Team-Sensorium/SensoBot/Images/Screenshot (390).png

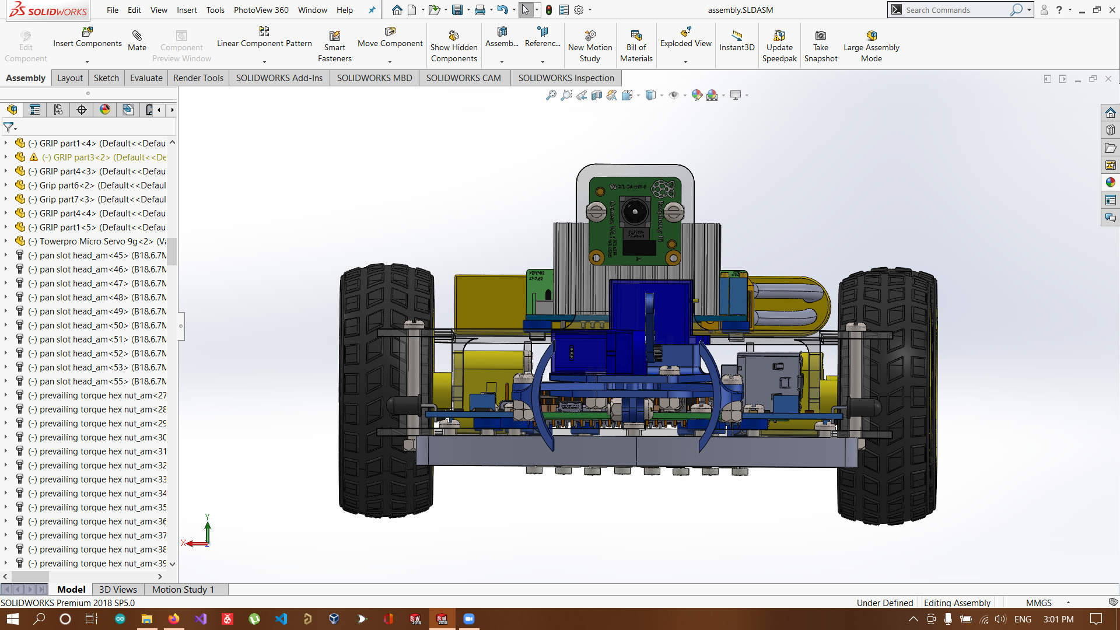
Images/Screenshot (390).png
