Team-Sensorium/SensoBot/Images/Screenshot (385).png

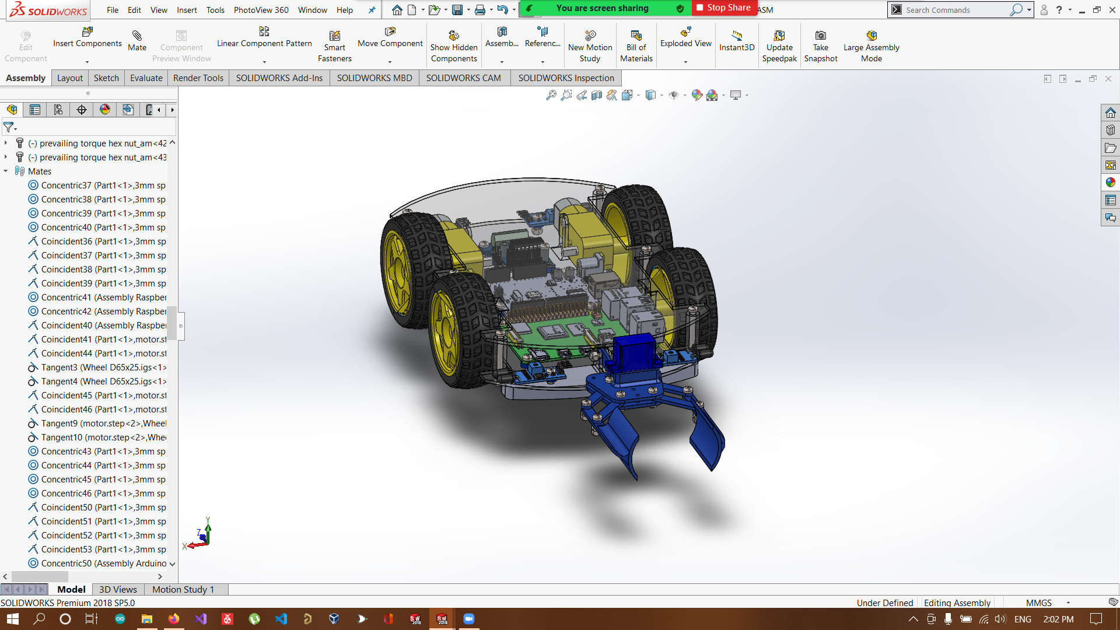
Images/Screenshot (385).png
