Team-Sensorium/SensoBot/Assignment PDFs/Assignment_3 190301H.pdf

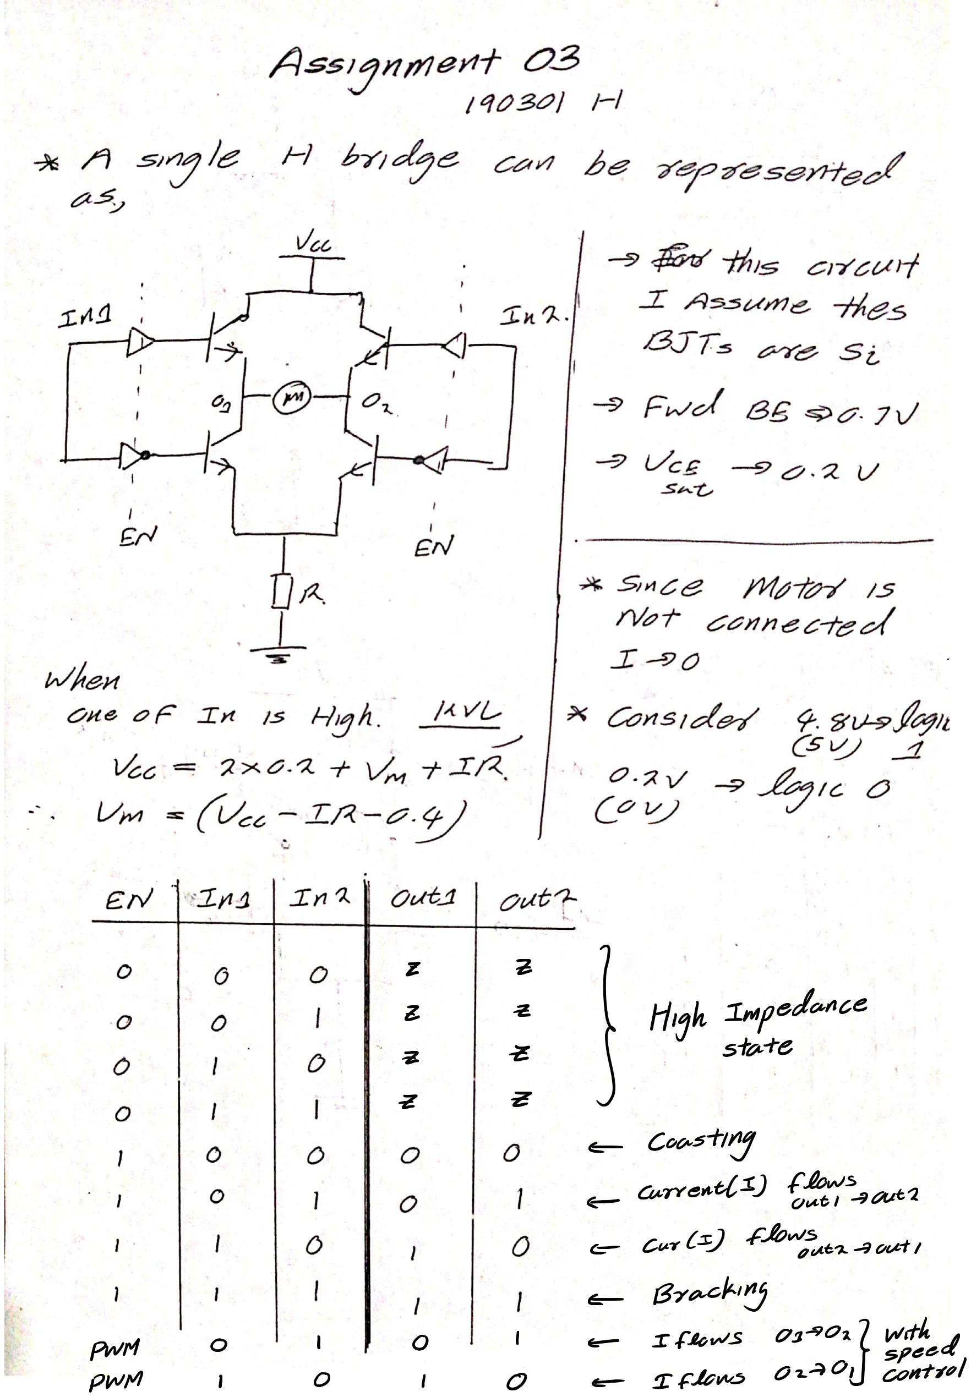
[picture p17: page 1]
