Team-Sensorium/SensoBot/Images/Render1.JPG

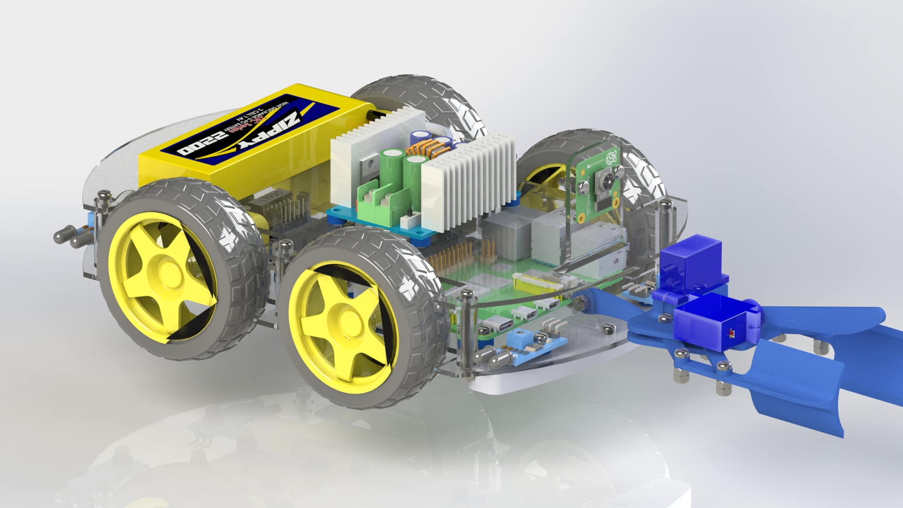
Images/Render1.JPG
