Team-Sensorium/SensoBot/Images/Screenshot (379).png

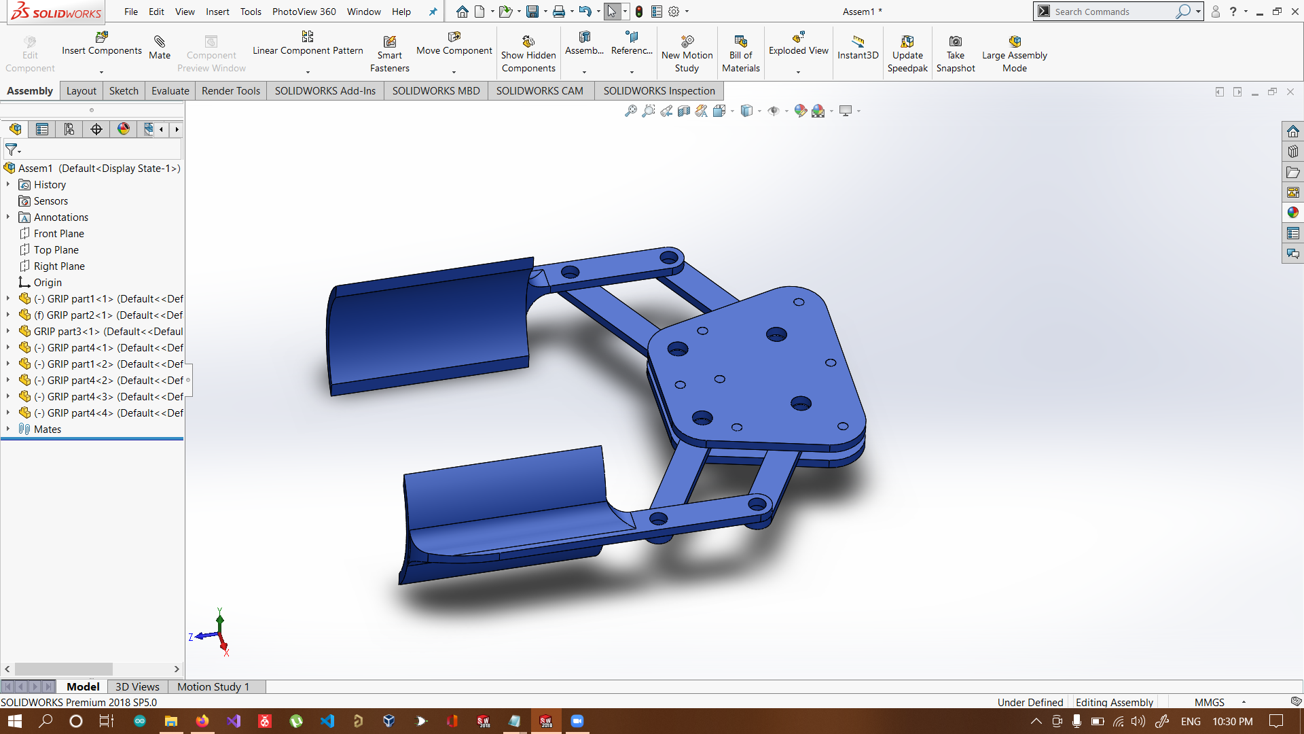
Images/Screenshot (379).png
