Team-Sensorium/SensoBot/Images/Screenshot (380).png

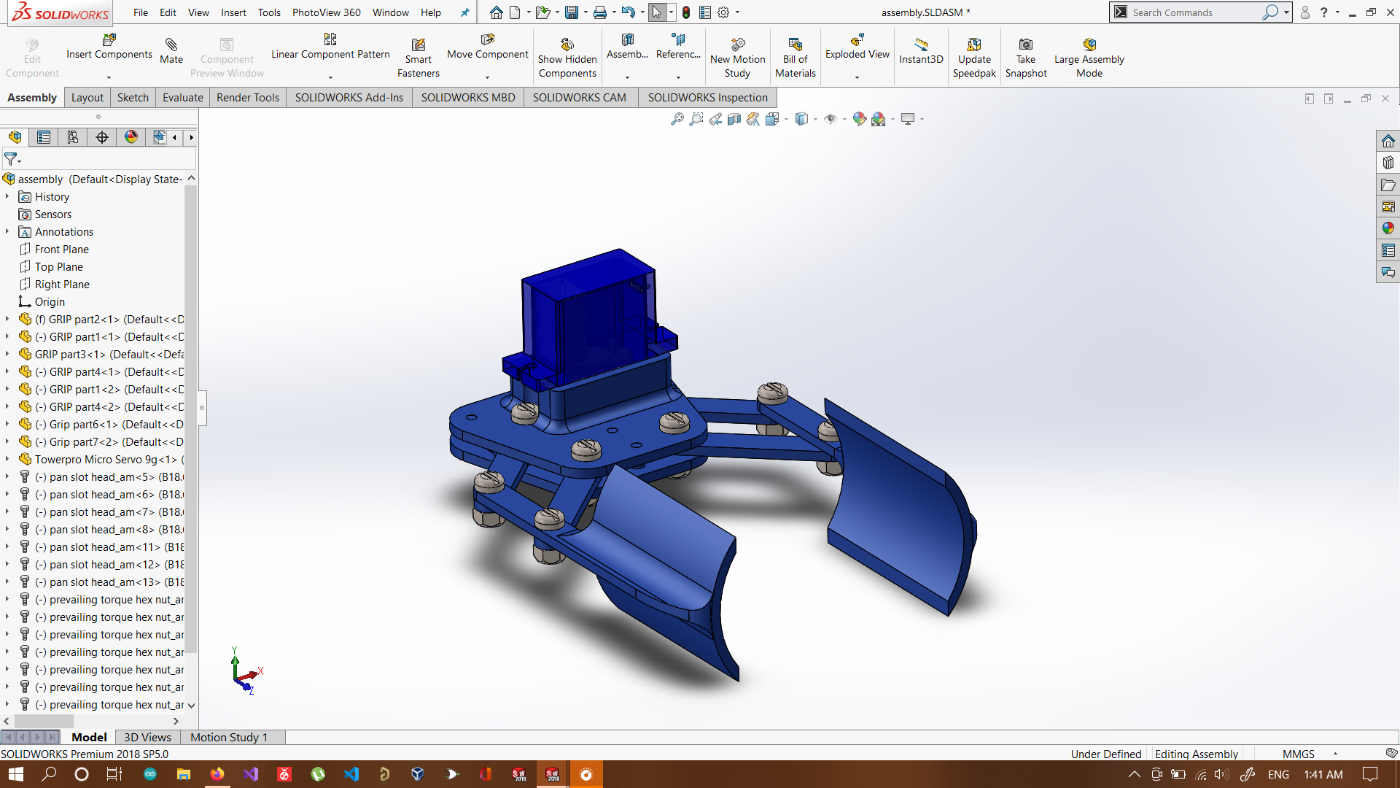
Images/Screenshot (380).png
