Team-Sensorium/SensoBot/Images/Screenshot (381).png

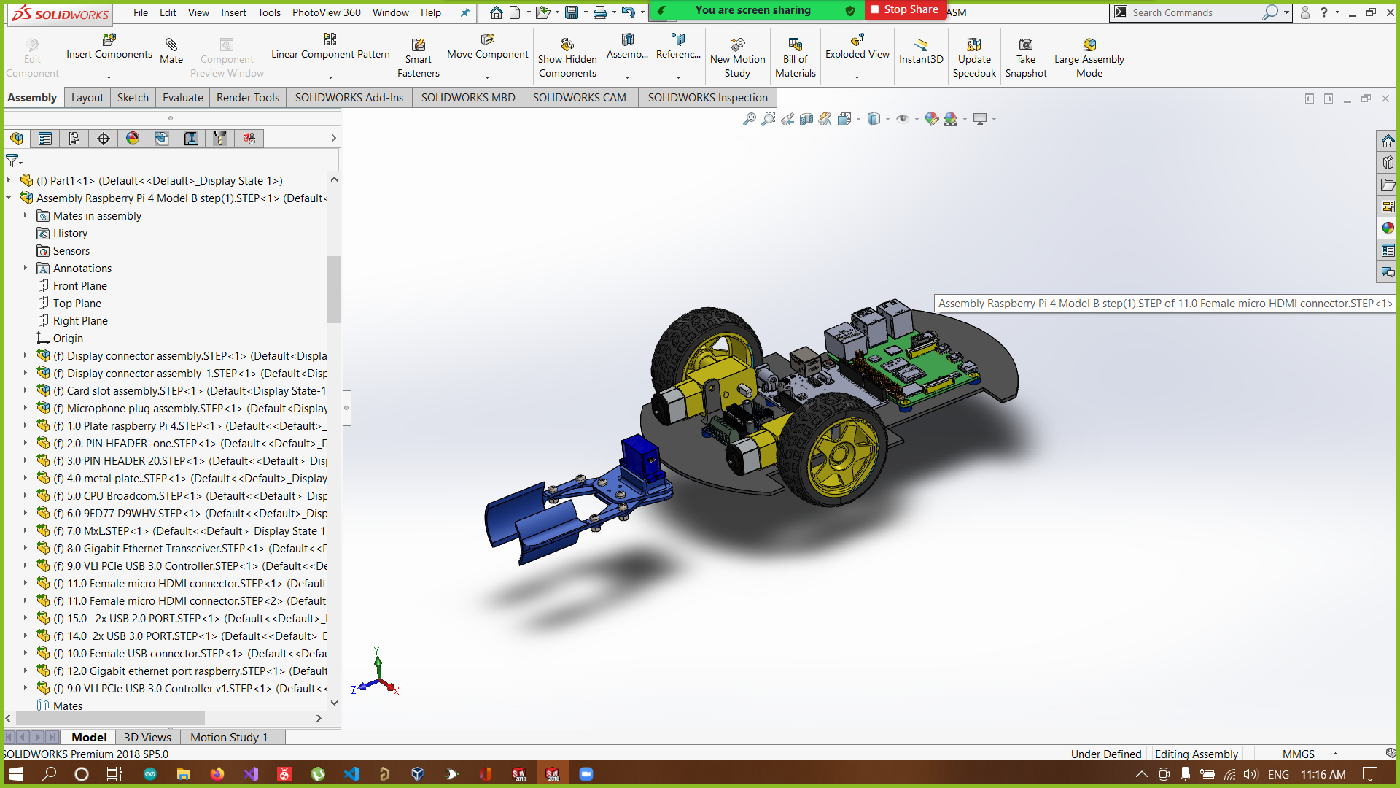
Images/Screenshot (381).png
