Team-Sensorium/SensoBot/Images/Screenshot (382).png

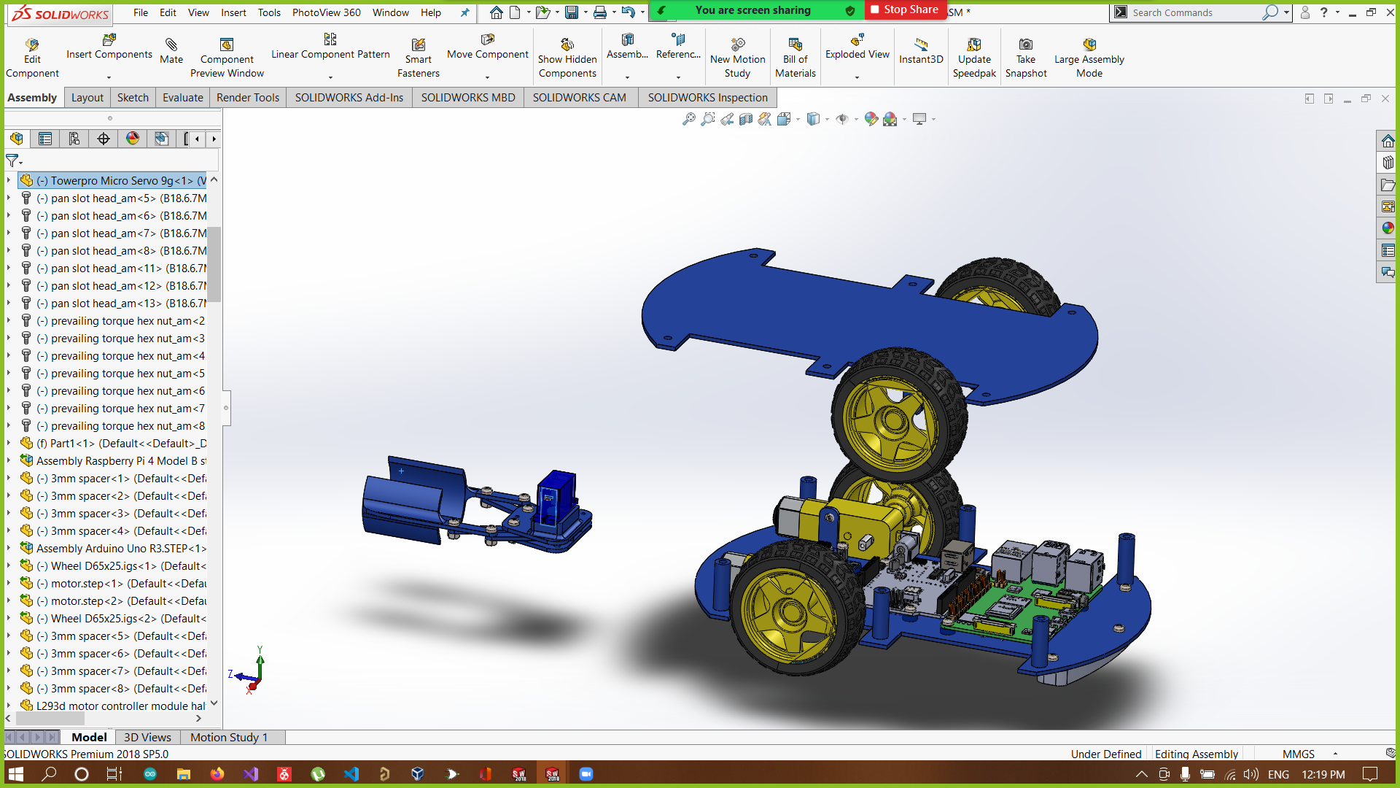
Images/Screenshot (382).png
