Team-Sensorium/SensoBot/Images/Screenshot (383).png

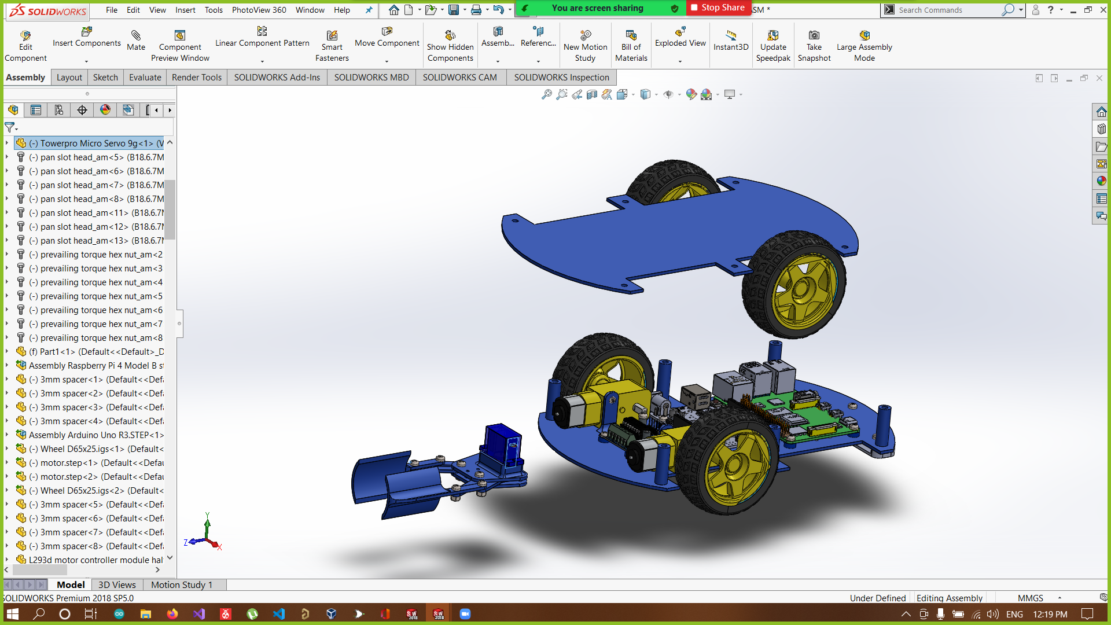
Images/Screenshot (383).png
