Team-Sensorium/SensoBot/Images/Screenshot (384).png

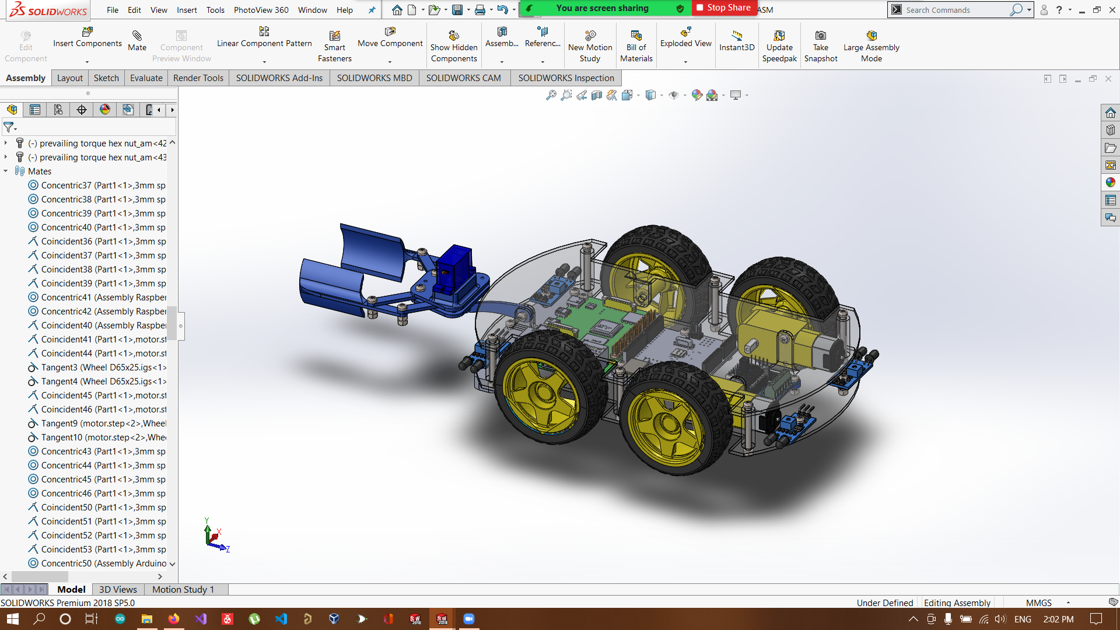
Images/Screenshot (384).png
