Team-Sensorium/SensoBot/Images/Screenshot (386).png

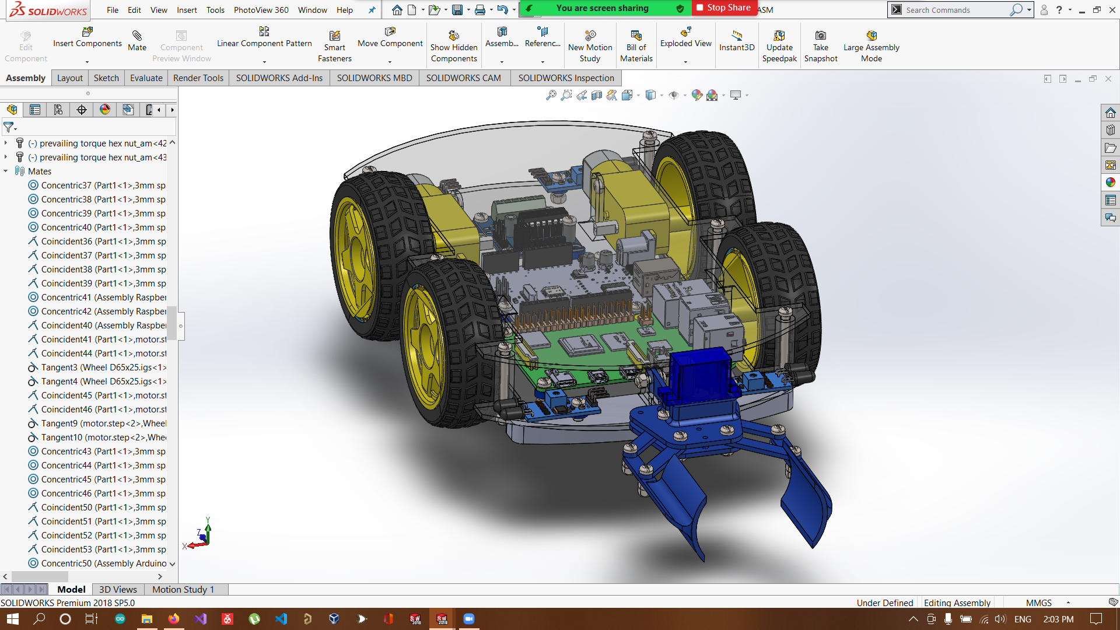
Images/Screenshot (386).png
