Team-Sensorium/SensoBot/Images/Screenshot (387).png

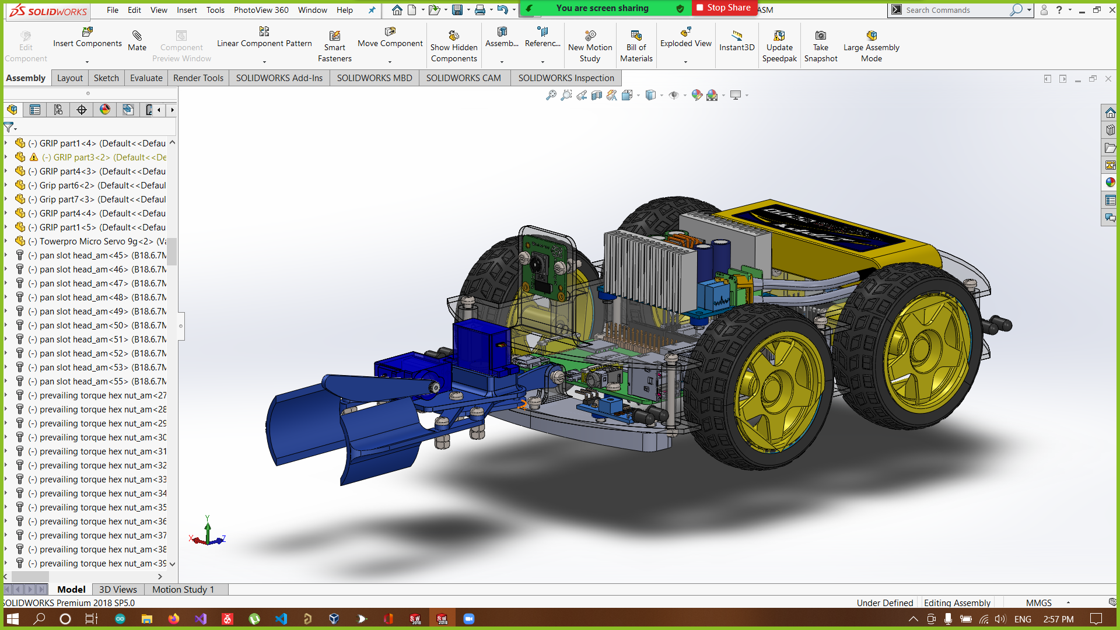
Images/Screenshot (387).png
