Team-Sensorium/SensoBot/Images/Screenshot (388).png

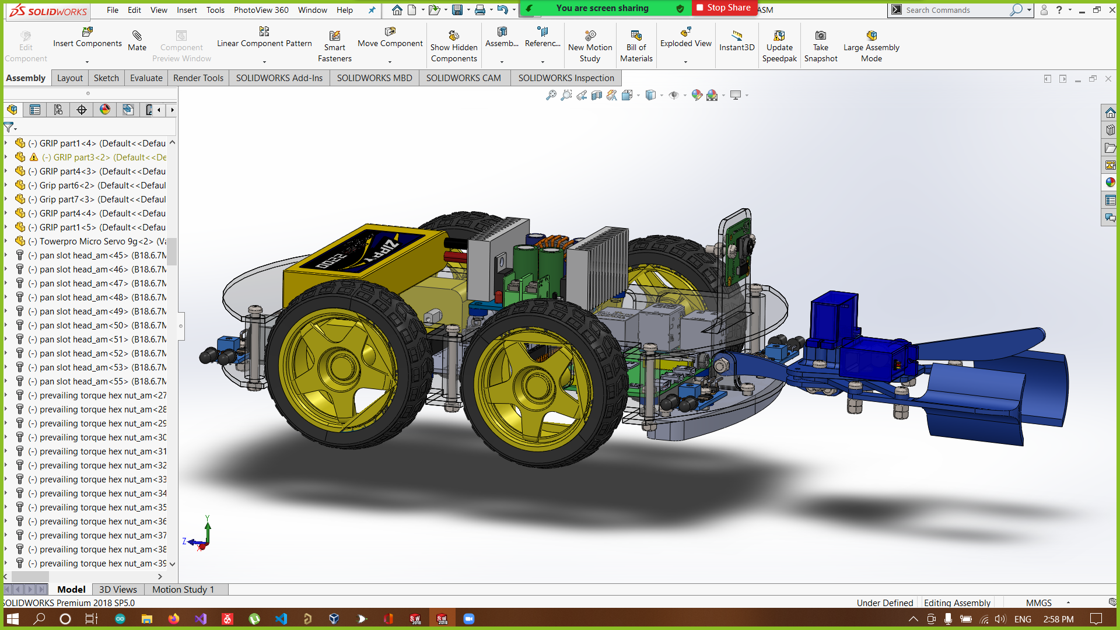
Images/Screenshot (388).png
