Team-Sensorium/SensoBot/Images/Screenshot (389).png

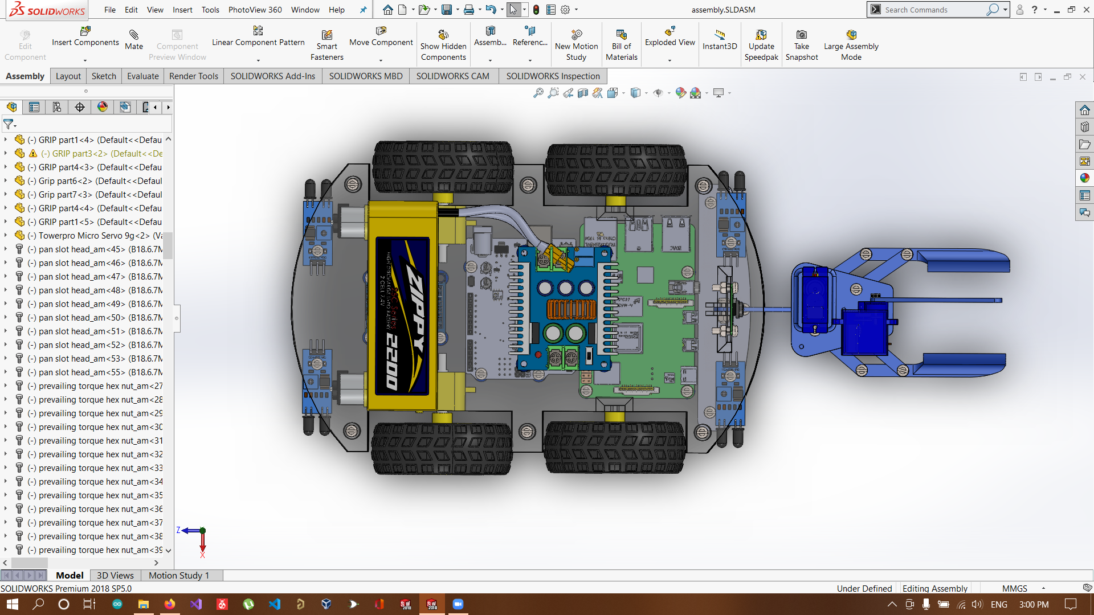
Images/Screenshot (389).png
