Team-Sensorium/SensoBot/Images/Screenshot (391).png

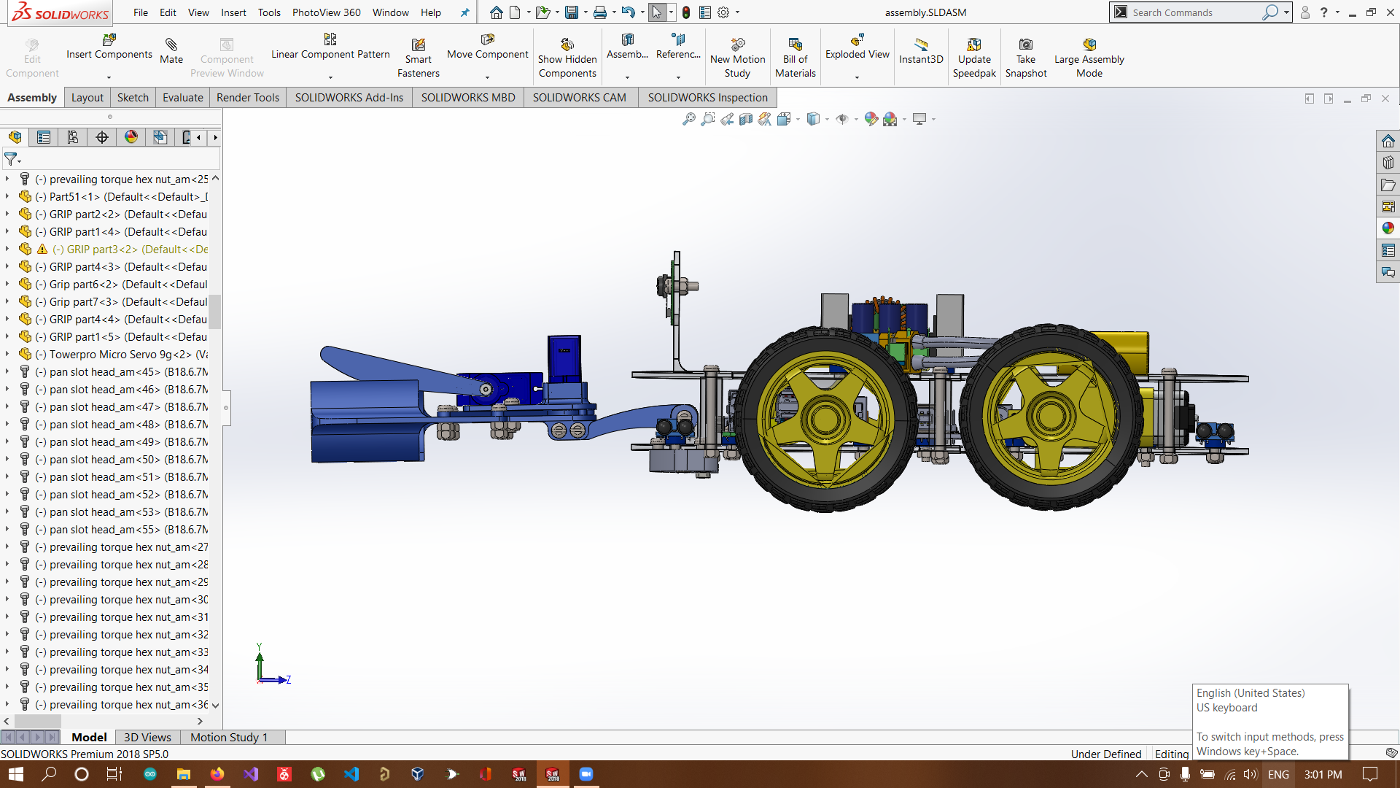
Images/Screenshot (391).png
