Team-Sensorium/SensoBot/Images/Screenshot (392).png

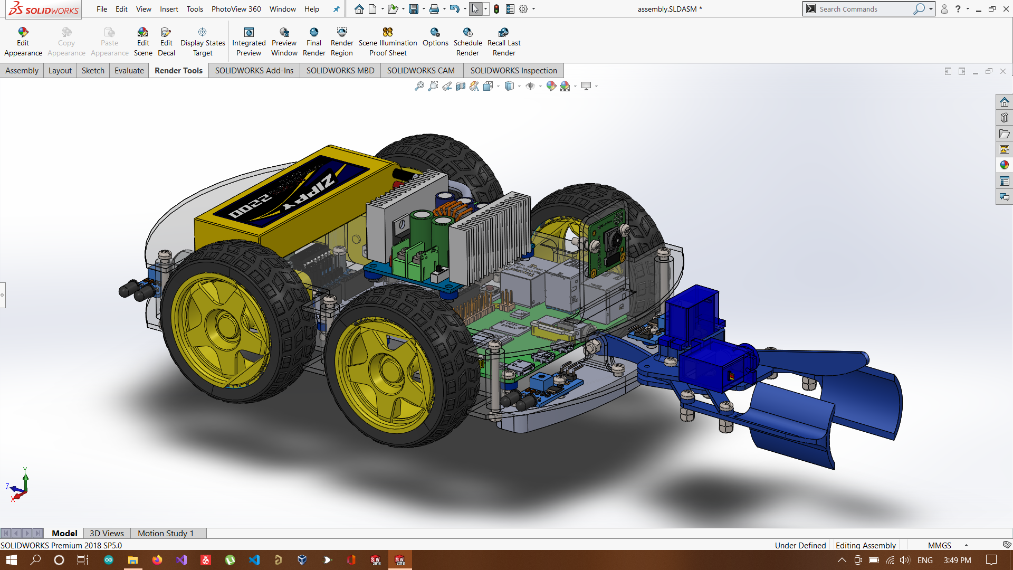
Images/Screenshot (392).png
