Team-Sensorium/SensoBot/Proof of Submition/Ass 4 submition.png

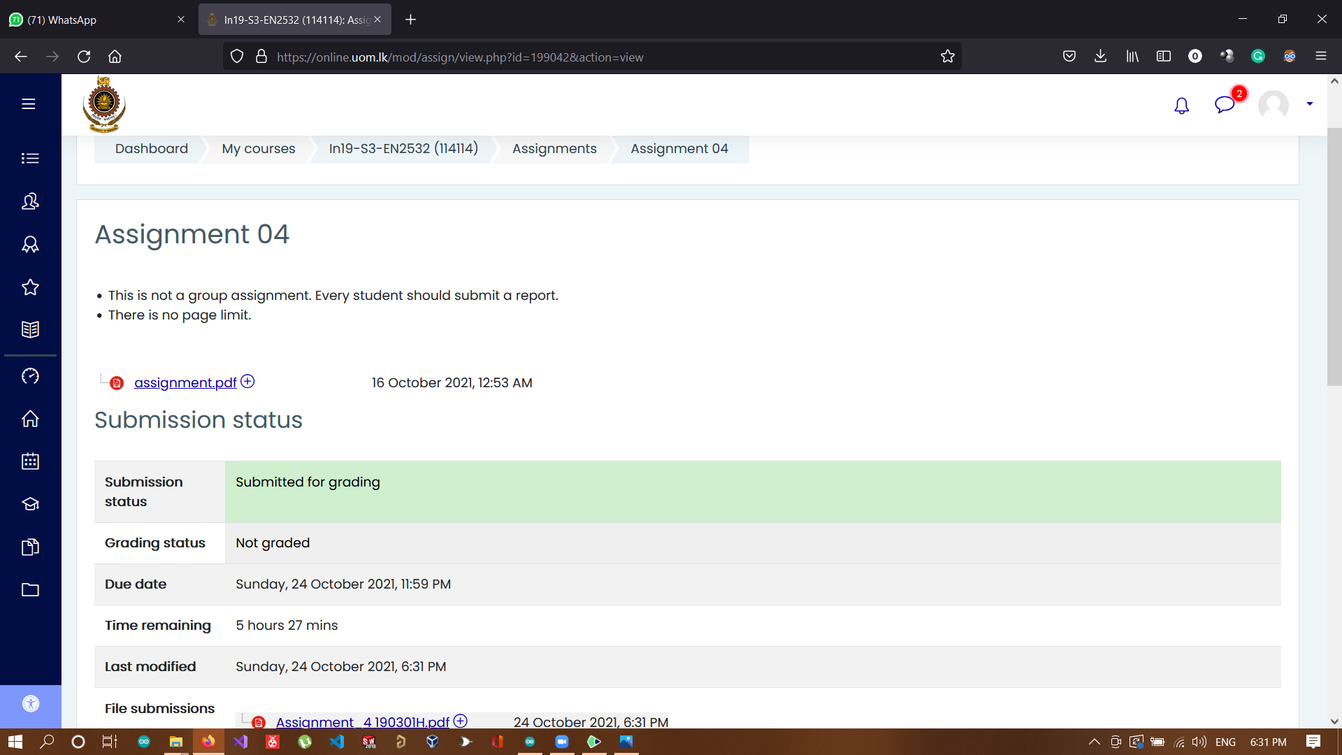
Proof of Submition/Ass 4 submition.png
