Team-Sensorium/SensoBot/Proof of Submition/Screenshot (358).png

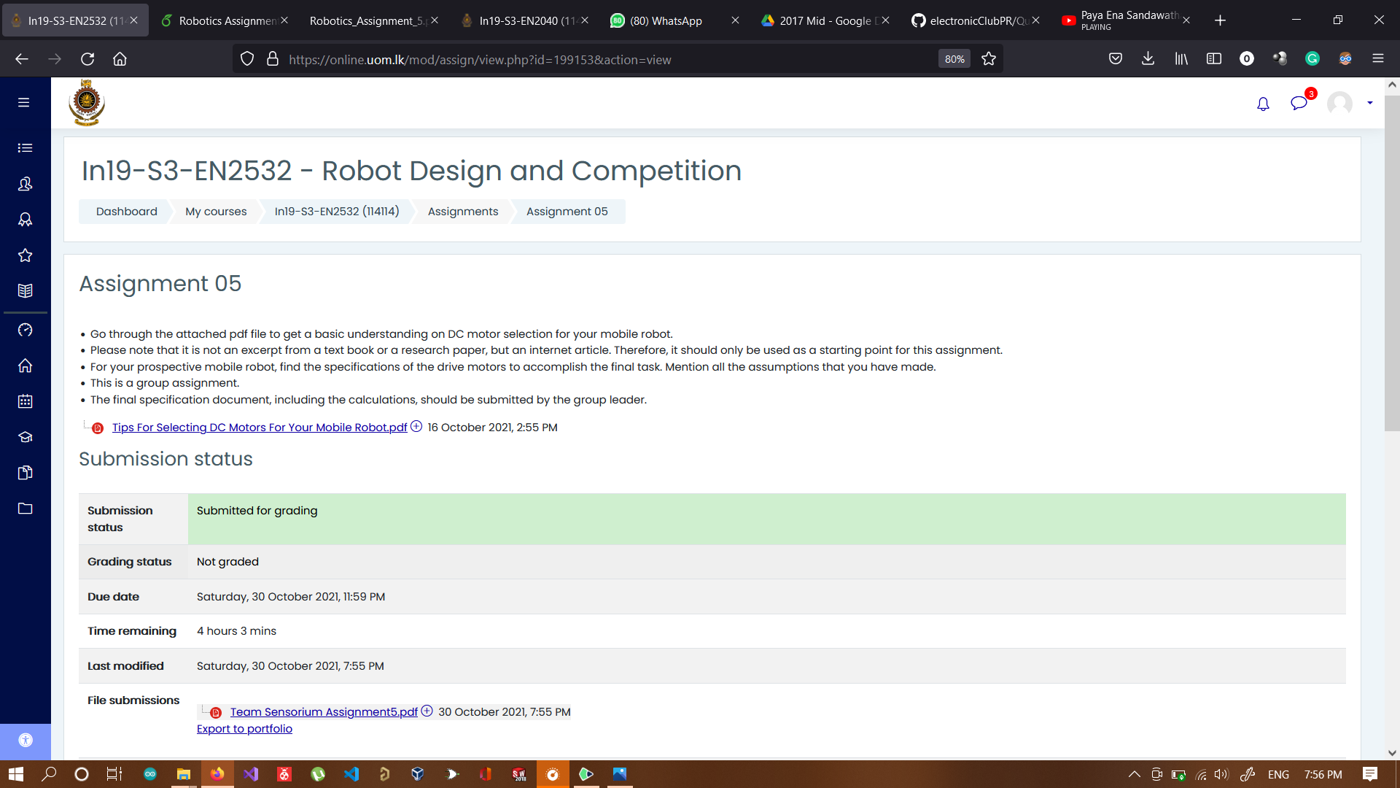
Proof of Submition/Screenshot (358).png
