Team-Sensorium/SensoBot/Proof of Submition/Screenshot (378).png

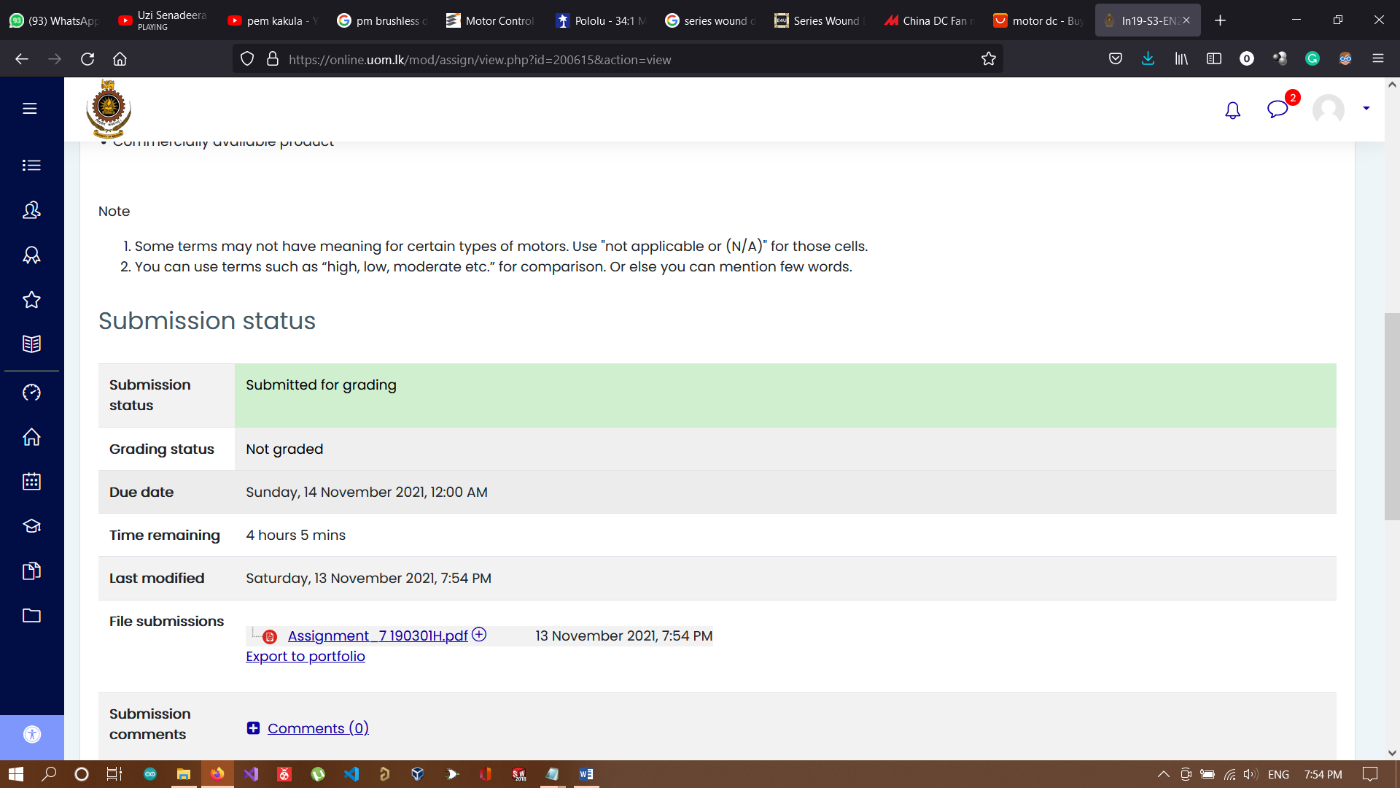
Proof of Submition/Screenshot (378).png
