Team-Sensorium/SensoBot/Proof of Submition/Screenshot (393).png

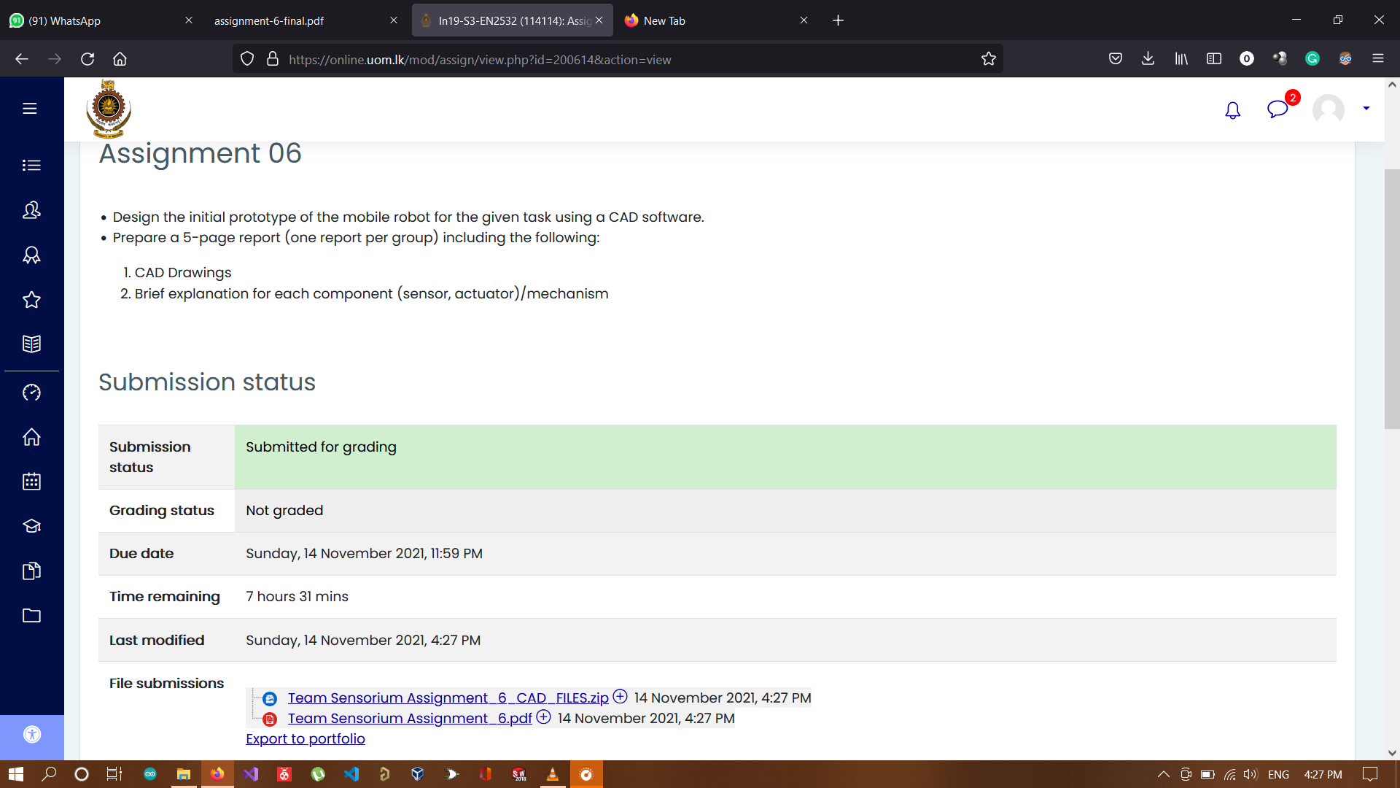
Proof of Submition/Screenshot (393).png
