Team-Sensorium/SensoBot/Webots/Working_Mossaic_BallShooting_combine_v2/controllers/Sensobot_controler1/6.png

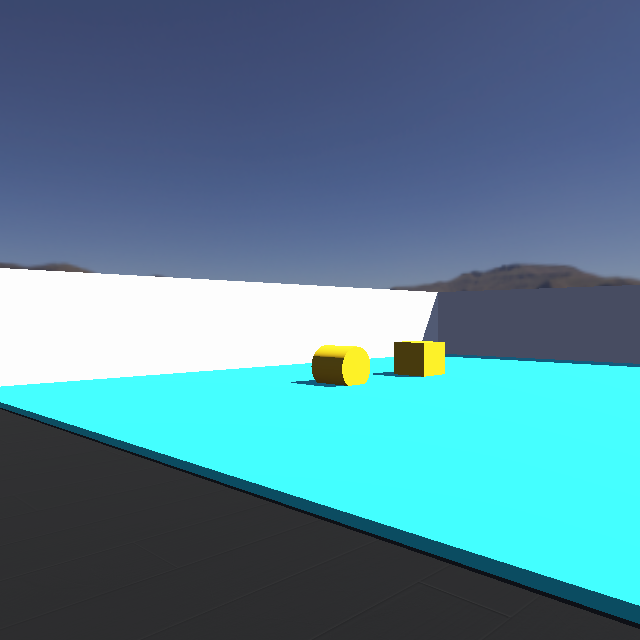
Webots/Working_Mossaic_BallShooting_combine_v2/controllers/Sensobot_controler1/6.png
