Team-Sensorium/SensoBot/CAD Designs/ARM/Assem1.SLDASM

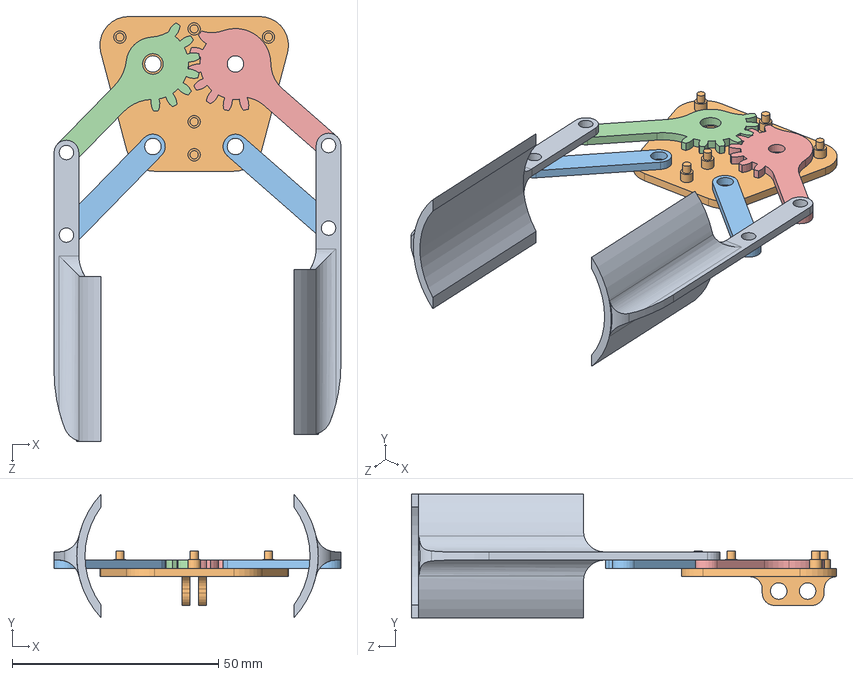
[picture p43: CAD file, 2022-02-23]
CAD Designs/ARM/Assem1.SLDASM
69.5 x 30.0 x 103.0 mm
GRIP part1 x 2
GRIP part2
GRIP part4 x 2
Grip part6
Grip part7
