Team-Sensorium/SensoBot/CAD Designs/Assembly for webots/Assembly/chassy.STEP

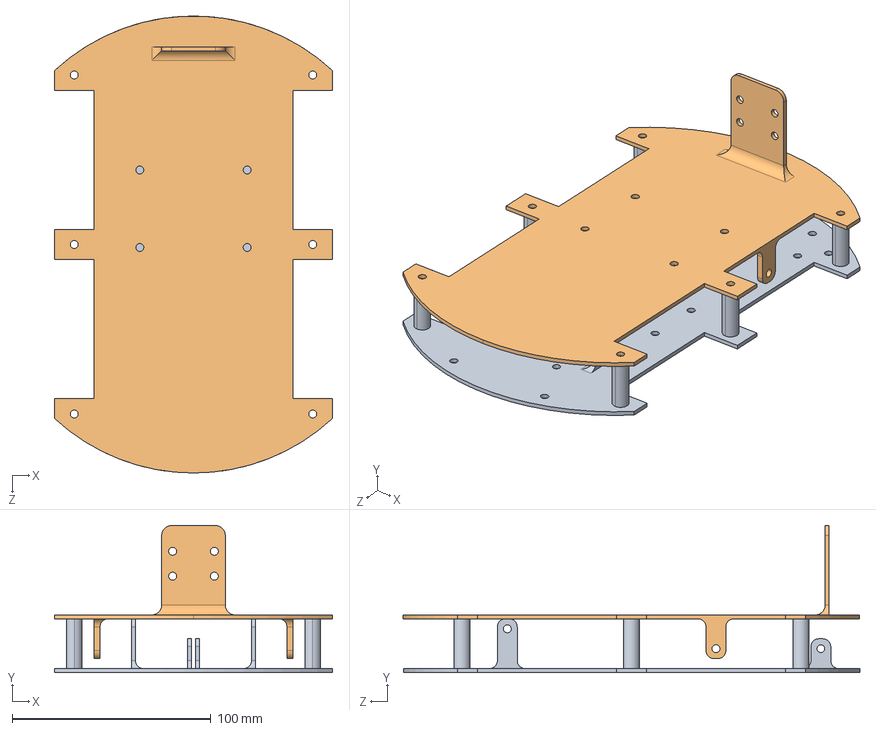
[picture p44: CAD file, 2022-02-23]
CAD Designs/Assembly for webots/Assembly/chassy.STEP
140.0 x 74.0 x 230.0 mm
