Team-Sensorium/SensoBot/CAD Designs/Assembly for webots/Arena/Parts/walls.STL

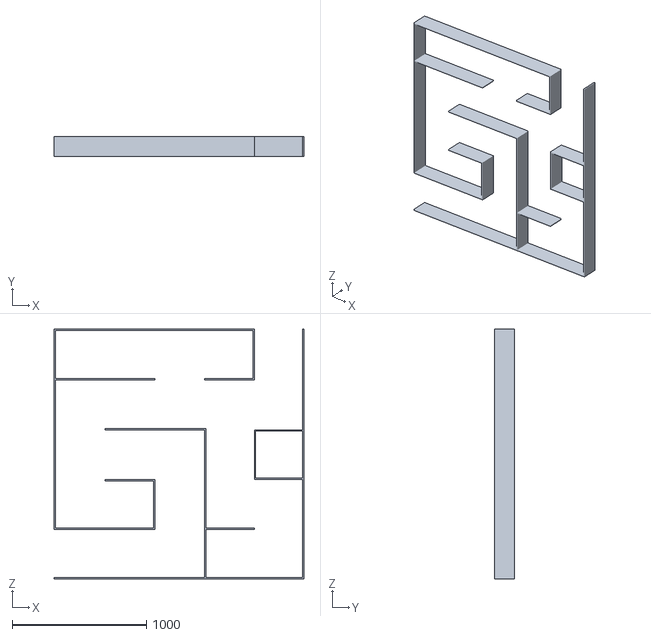
[picture p45: CAD file, 2022-02-23]
CAD Designs/Assembly for webots/Arena/Parts/walls.STL
1860.0 x 150.0 x 1860.0
