Team-Sensorium/SensoBot/CAD Designs/Assembly for webots/Assembly/Wheel D65x25.SLDPRT

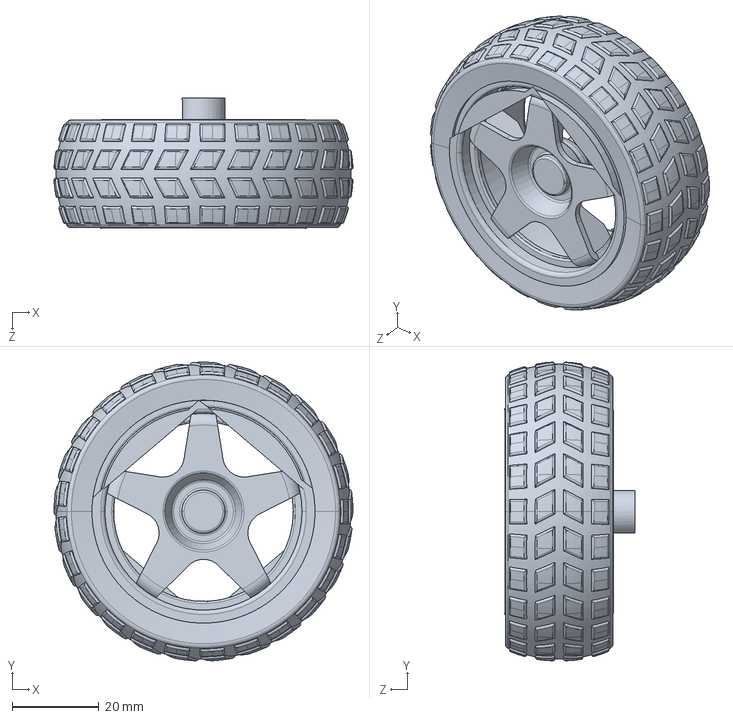
[picture p46: CAD file, 2022-02-23]
CAD Designs/Assembly for webots/Assembly/Wheel D65x25.SLDPRT
68.9 x 68.9 x 30.0 mm
