Team-Sensorium/SensoBot/CAD Designs/Assembly for webots/dotted_path1.STL

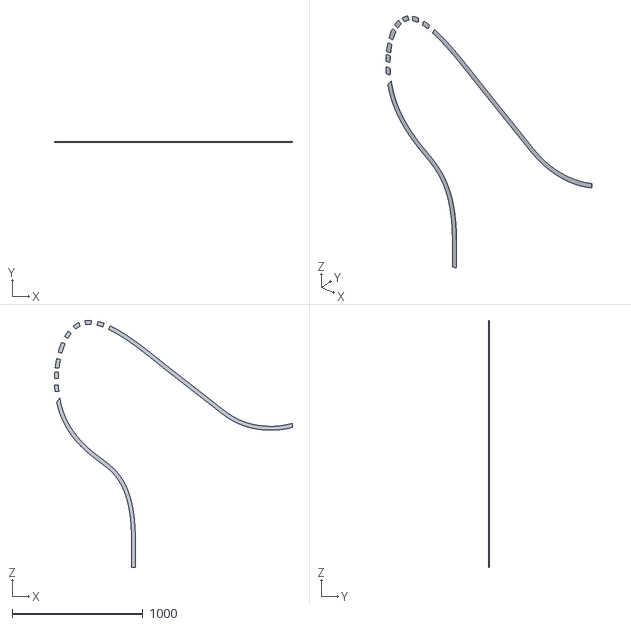
[picture p47: CAD file, 2022-02-24]
CAD Designs/Assembly for webots/dotted_path1.STL
1819.7 x 10.0 x 1890.8
