Team-Sensorium/SensoBot/CAD Designs/Assembly/bat.SLDPRT

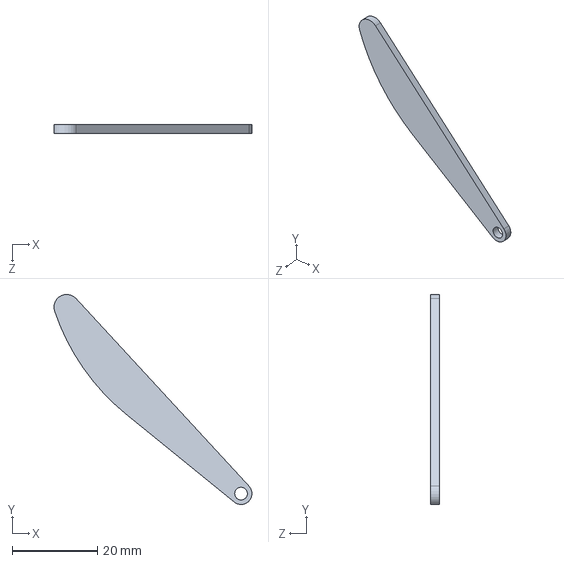
[picture p48: CAD file, 2021-11-14]
CAD Designs/Assembly/bat.SLDPRT
46.6 x 49.4 x 2.00 mm
