Team-Sensorium/SensoBot/Webots/Working_Mossaic_BallShooting_combine_v2/worlds/entrance_path_test_arena.STL

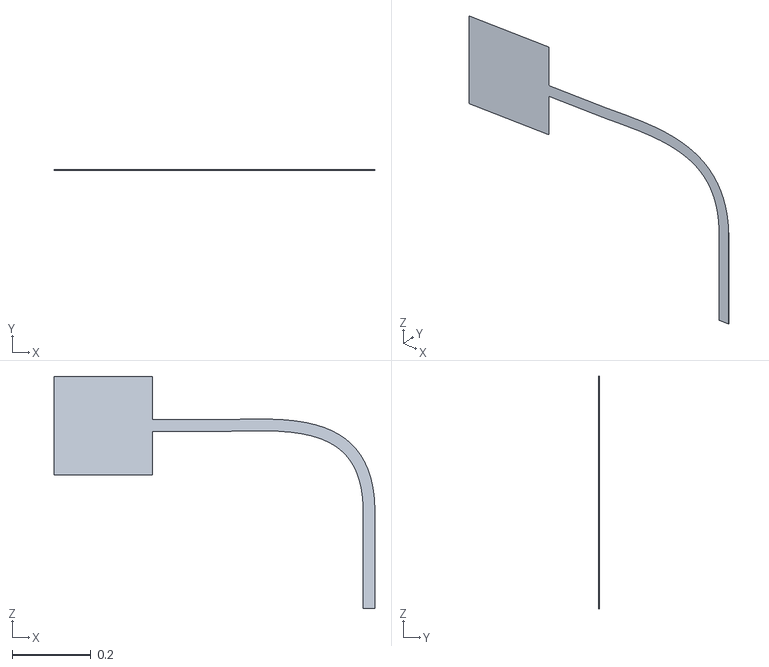
[picture p49: CAD file, 2022-02-23]
Webots/Working_Mossaic_BallShooting_combine_v2/worlds/entrance_path_test_arena.STL
0.815 x 0.001 x 0.59
