Team-Sensorium/SensoBot/CAD Designs/ARM/GRIP part3.SLDPRT

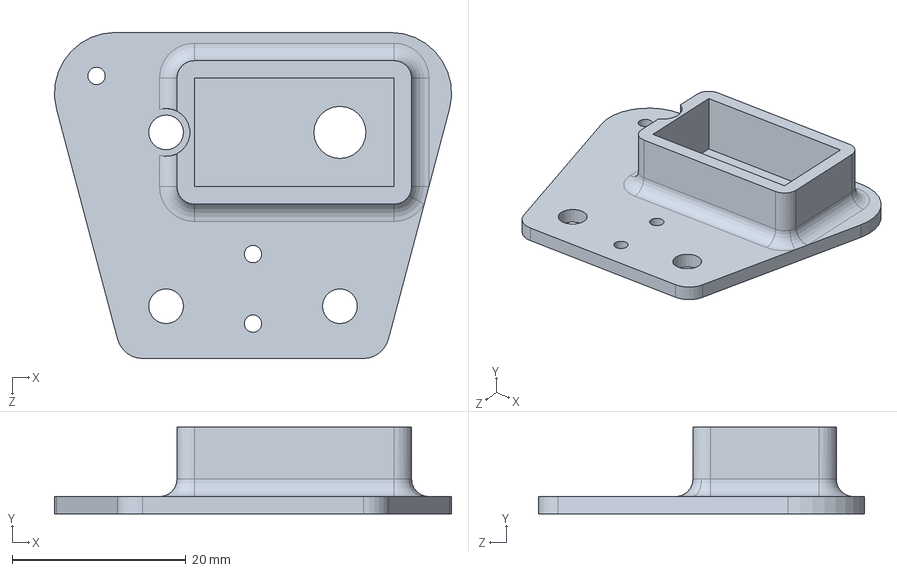
[picture p50: CAD file, 2022-02-23]
CAD Designs/ARM/GRIP part3.SLDPRT
45.7 x 10.0 x 37.5 mm
