Team-Sensorium/SensoBot/CAD Designs/Assembly for webots/Part2.SLDPRT

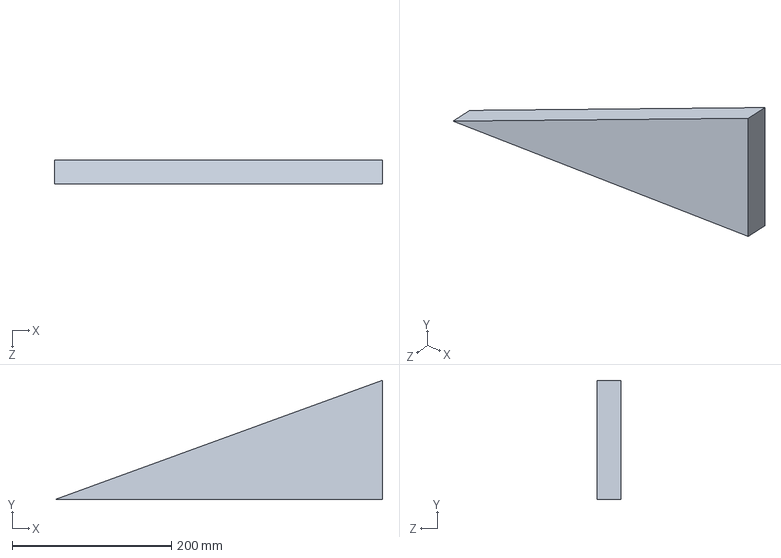
[picture p51: CAD file, 2022-02-23]
CAD Designs/Assembly for webots/Part2.SLDPRT
412.0 x 150.0 x 30.0 mm
