Team-Sensorium/SensoBot/Webots/Working_Mossaic_BallShooting_combine_v2/worlds/key_hole_outline.STL

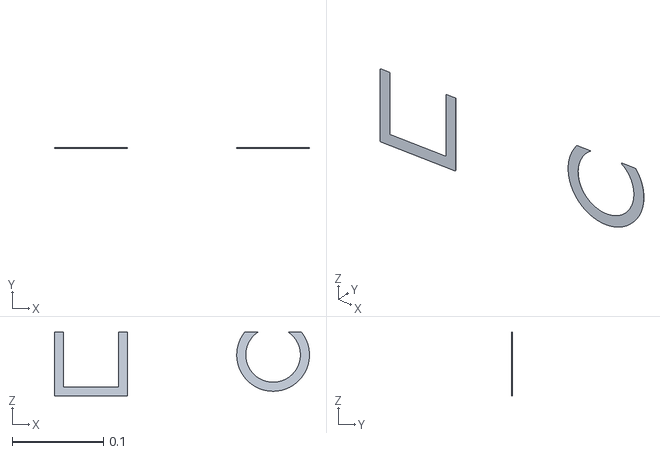
[picture p53: CAD file, 2022-02-23]
Webots/Working_Mossaic_BallShooting_combine_v2/worlds/key_hole_outline.STL
0.28 x 0.001 x 0.07
