Team-Sensorium/SensoBot/CAD Designs/ARM/Grip part5.SLDPRT

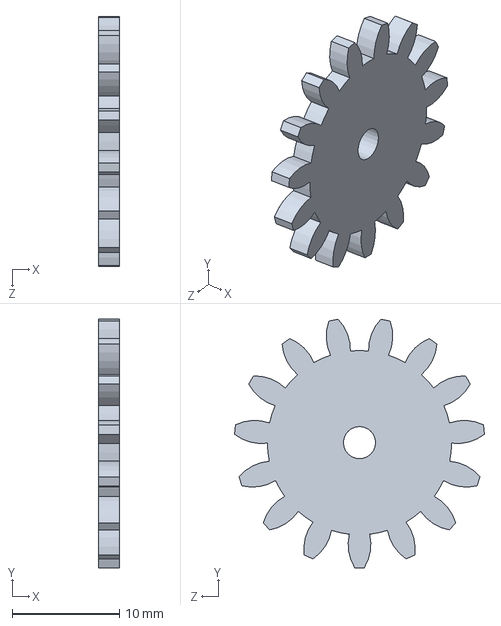
[picture p54: CAD file, 2021-11-14]
CAD Designs/ARM/Grip part5.SLDPRT
2.00 x 23.2 x 23.3 mm
