Team-Sensorium/SensoBot/CAD Designs/Assembly for webots/Arena/Parts/path1.STL

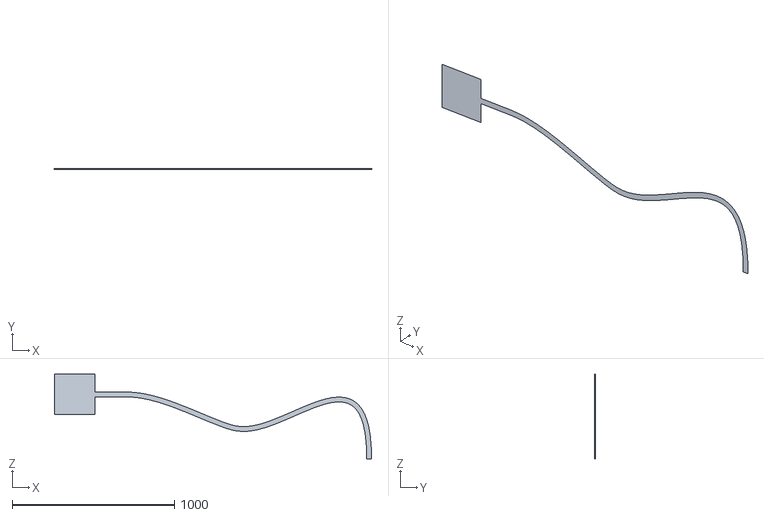
[picture p55: CAD file, 2022-02-23]
CAD Designs/Assembly for webots/Arena/Parts/path1.STL
1955.0 x 1.00 x 522.8
