Team-Sensorium/SensoBot/CAD Designs/Assembly for webots/path1.SLDPRT

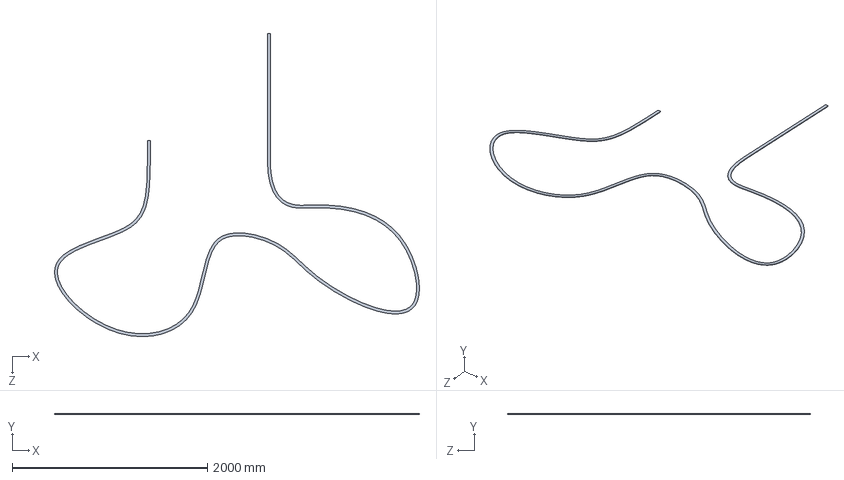
[picture p56: CAD file, 2022-02-23]
CAD Designs/Assembly for webots/path1.SLDPRT
3741.9 x 10.0 x 3109.9 mm
