Team-Sensorium/SensoBot/Webots/Working_Mossaic_BallShooting_combine_v2/worlds/maze_test_arena.STL

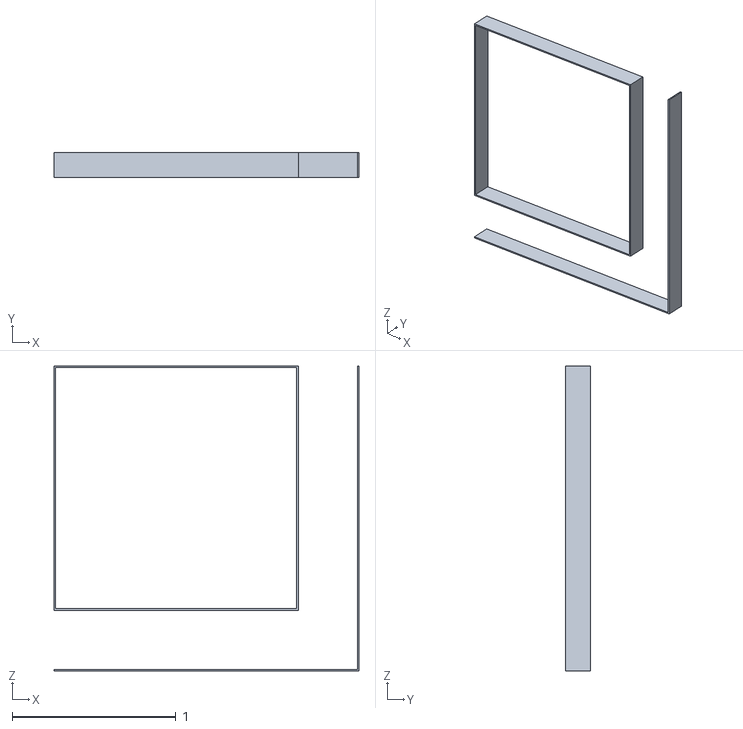
[picture p57: CAD file, 2022-02-23]
Webots/Working_Mossaic_BallShooting_combine_v2/worlds/maze_test_arena.STL
1.86 x 0.15 x 1.86
