Team-Sensorium/SensoBot/CAD Designs/Assembly/Towerpro Micro Servo 9g.SLDPRT

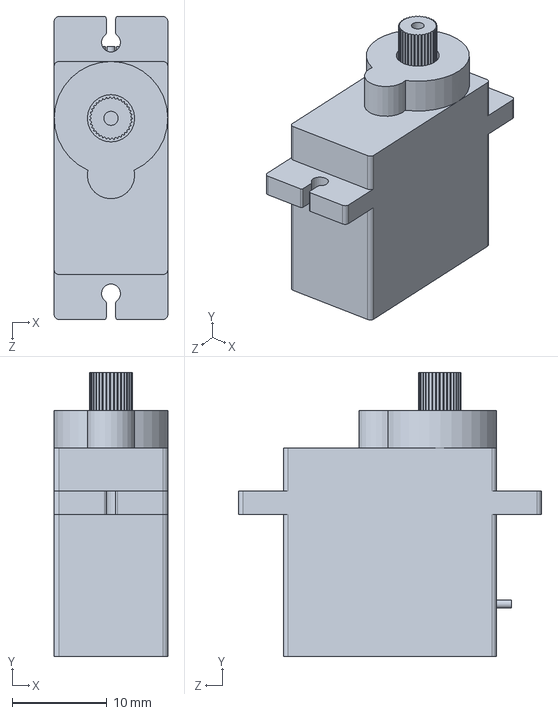
[picture p58: CAD file, 2021-11-14]
CAD Designs/Assembly/Towerpro Micro Servo 9g.SLDPRT
12.0 x 30.0 x 32.0 mm
