Team-Sensorium/SensoBot/Webots/Working_Mossaic_BallShooting_combine_v2/worlds/CMYK_area_fillet.STL

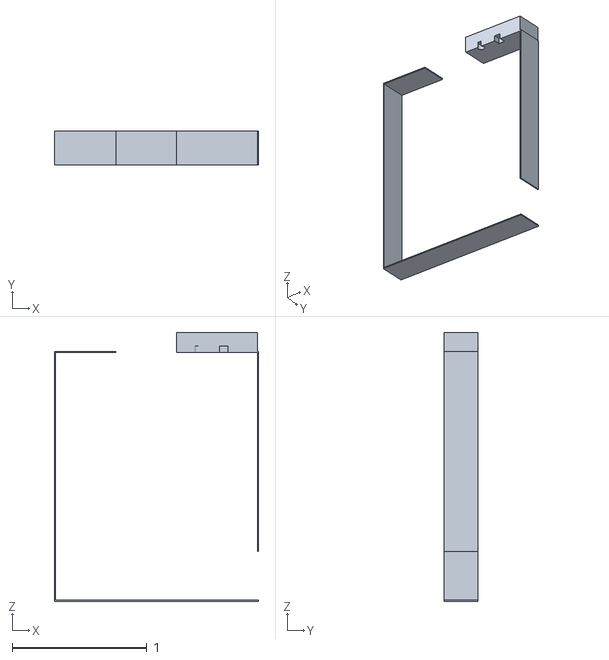
[picture p59: CAD file, 2022-02-23]
Webots/Working_Mossaic_BallShooting_combine_v2/worlds/CMYK_area_fillet.STL
1.52 x 0.25 x 2.00
