Team-Sensorium/SensoBot/CAD Designs/Assembly/IR Sensor (FC51).SLDPRT

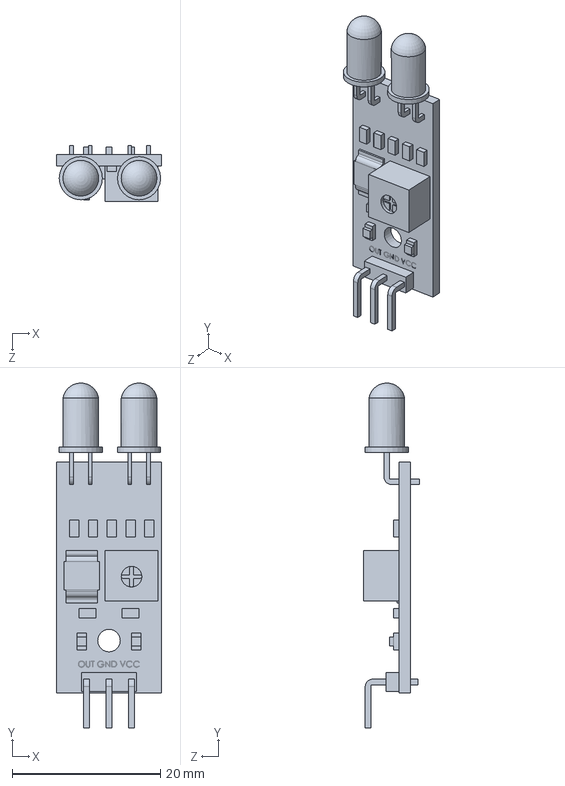
[picture p60: CAD file, 2021-11-14]
CAD Designs/Assembly/IR Sensor (FC51).SLDPRT
14.2 x 46.6 x 7.62 mm
