Team-Sensorium/SensoBot/CAD Designs/Assembly/Cam V2.1 v1.step

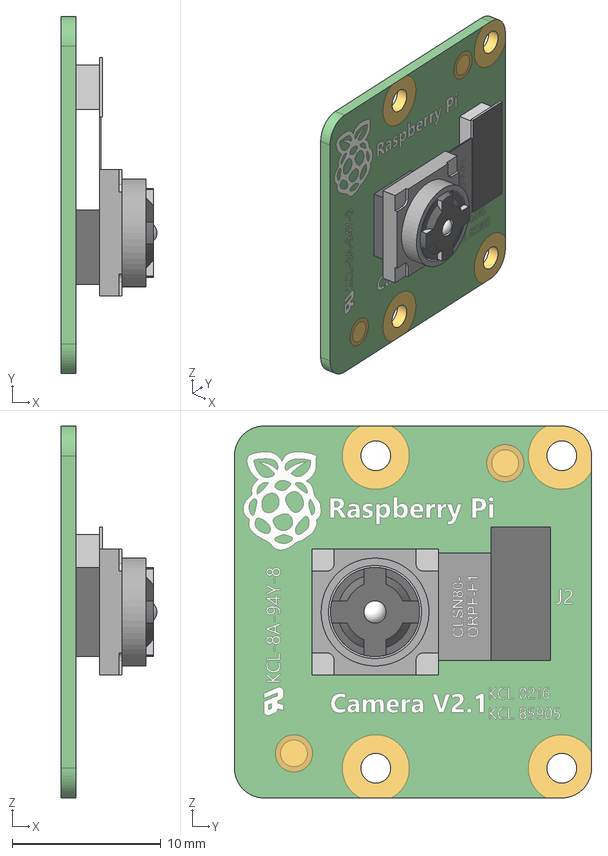
[picture p61: CAD file, 2021-11-14]
CAD Designs/Assembly/Cam V2.1 v1.step
6.45 x 24.0 x 25.0 mm
