Team-Sensorium/SensoBot/CAD Designs/Assembly/motor.STEP

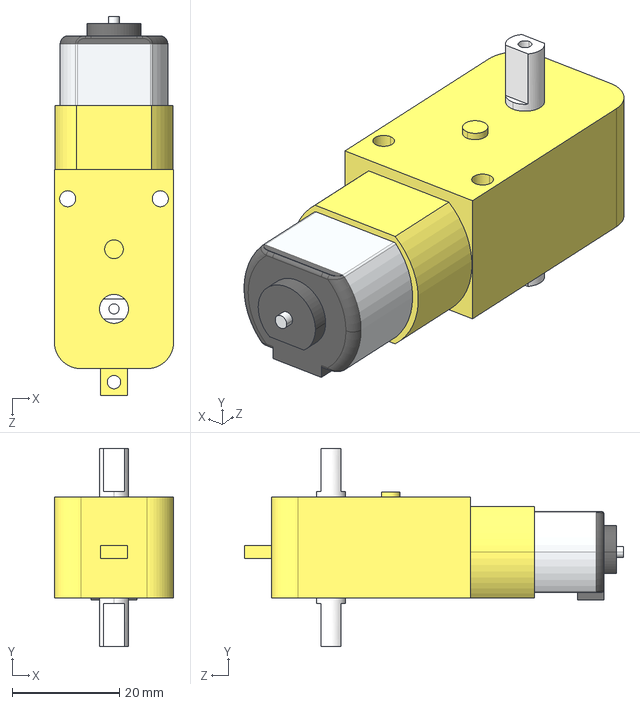
[picture p62: CAD file, 2021-11-14]
CAD Designs/Assembly/motor.STEP
22.3 x 37.0 x 70.8 mm
