Team-Sensorium/SensoBot/CAD Designs/Assembly/3mm spacer.SLDPRT

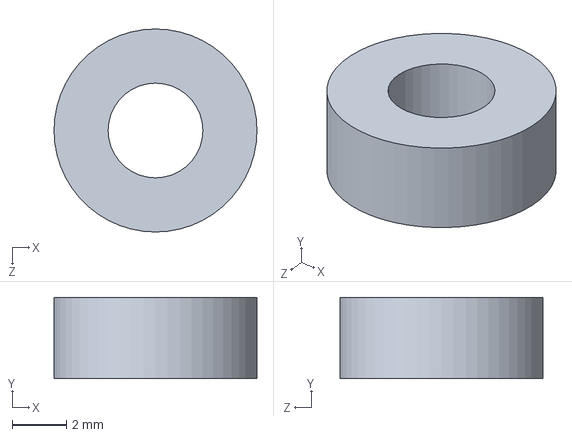
[picture p63: CAD file, 2021-11-14]
CAD Designs/Assembly/3mm spacer.SLDPRT
7.50 x 3.00 x 7.50 mm
