Team-Sensorium/SensoBot/CAD Designs/Assembly/Part1.SLDPRT

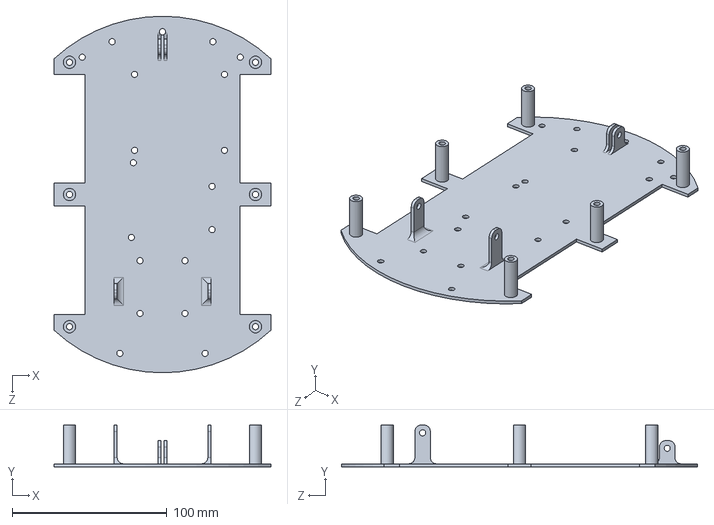
[picture p64: CAD file, 2021-11-14]
CAD Designs/Assembly/Part1.SLDPRT
140.0 x 27.0 x 230.0 mm
