Team-Sensorium/SensoBot/CAD Designs/Assembly/Part1 - Upper.SLDPRT

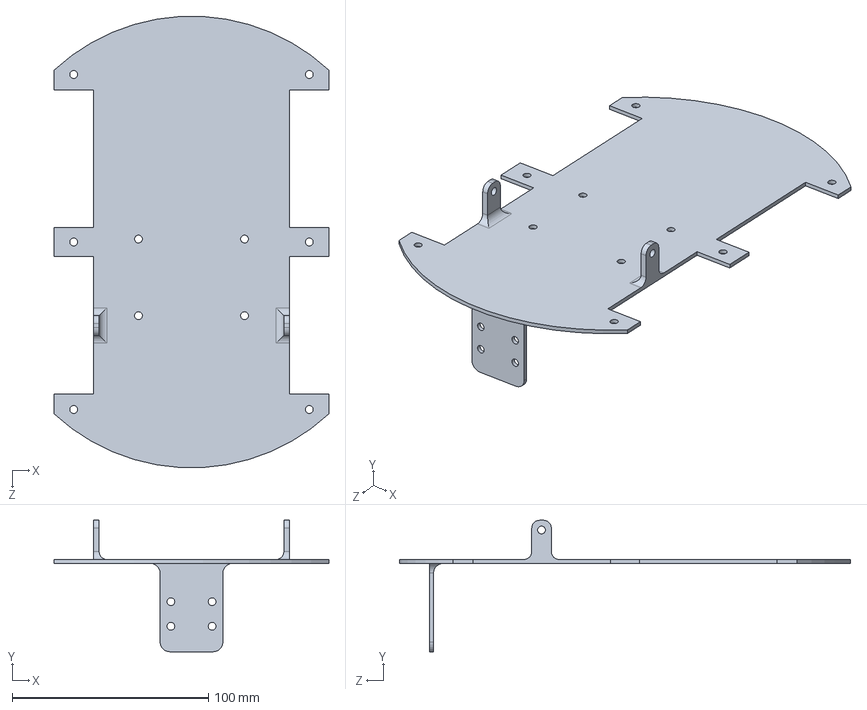
[picture p65: CAD file, 2021-11-14]
CAD Designs/Assembly/Part1 - Upper.SLDPRT
140.0 x 67.0 x 229.7 mm
