Team-Sensorium/SensoBot/CAD Designs/Assembly/Grip part7.SLDPRT

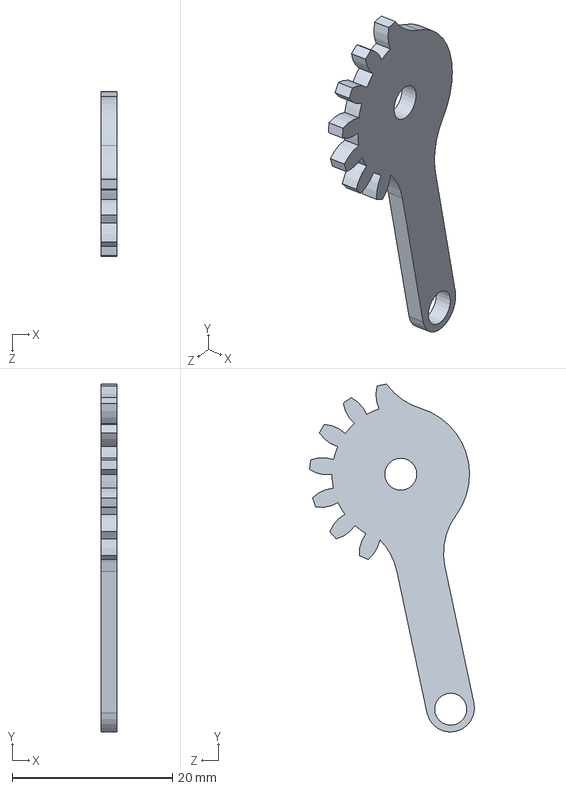
[picture p66: CAD file, 2021-11-14]
CAD Designs/Assembly/Grip part7.SLDPRT
2.00 x 43.5 x 20.6 mm
