Team-Sensorium/SensoBot/CAD Designs/Assembly/GRIP part1.SLDPRT

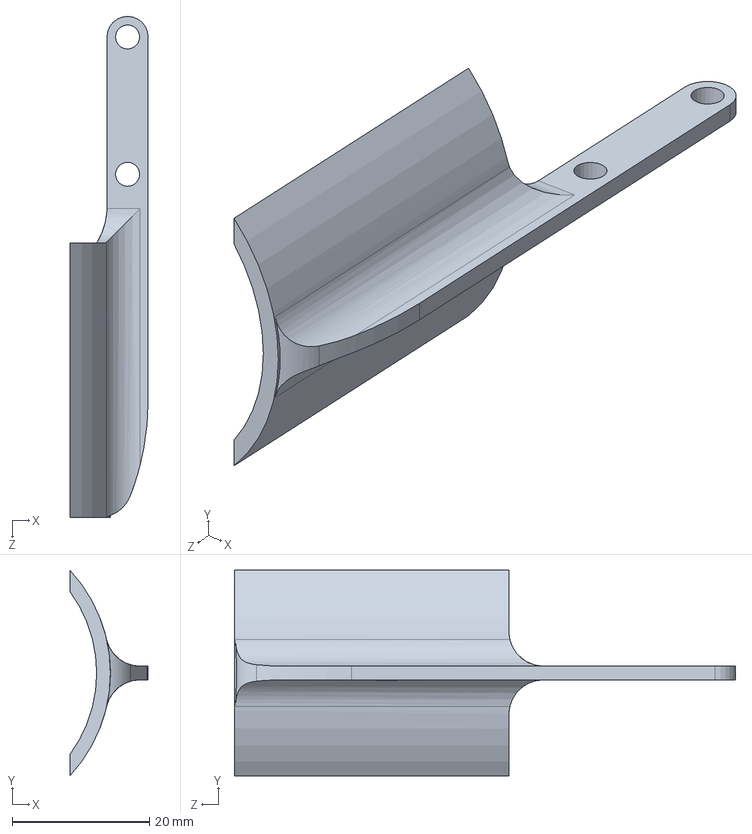
[picture p67: CAD file, 2021-11-14]
CAD Designs/Assembly/GRIP part1.SLDPRT
11.4 x 30.0 x 73.0 mm
