Team-Sensorium/SensoBot/CAD Designs/Assembly/GRIP part3.SLDPRT

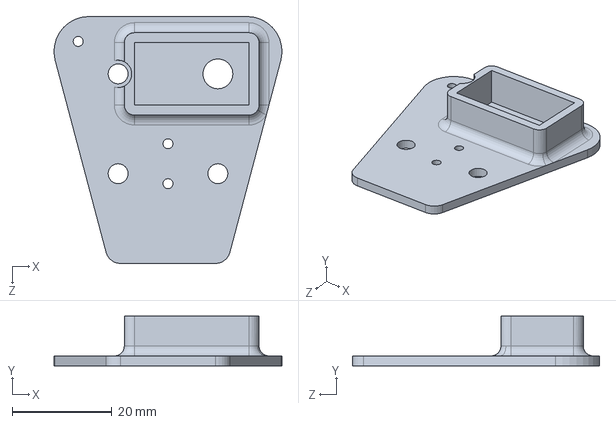
[picture p68: CAD file, 2021-11-14]
CAD Designs/Assembly/GRIP part3.SLDPRT
45.7 x 10.0 x 49.5 mm
