Team-Sensorium/SensoBot/CAD Designs/Assembly/GRIP part4.SLDPRT

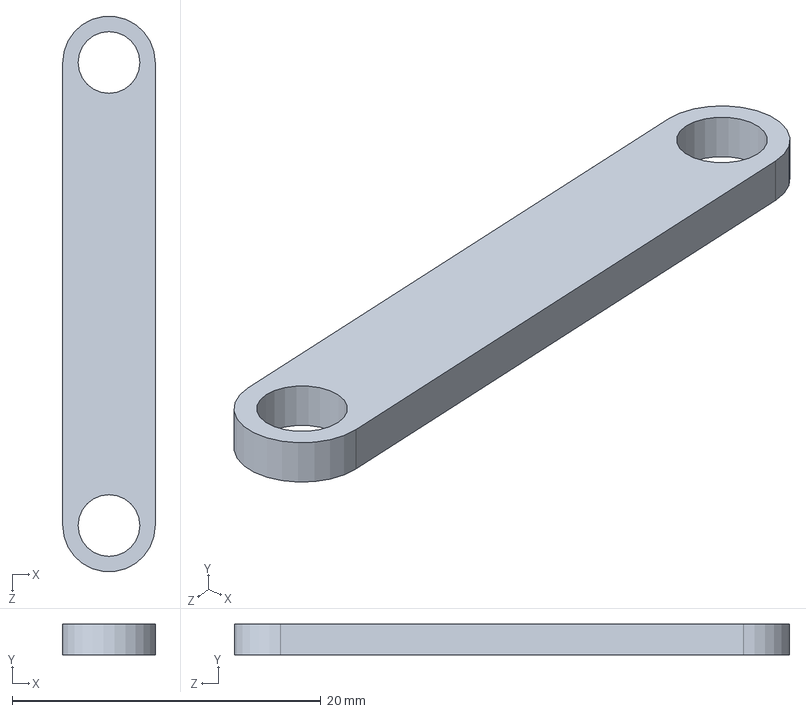
[picture p69: CAD file, 2021-11-14]
CAD Designs/Assembly/GRIP part4.SLDPRT
6.00 x 2.00 x 36.0 mm
