Team-Sensorium/SensoBot/CAD Designs/Assembly/Part51.SLDPRT

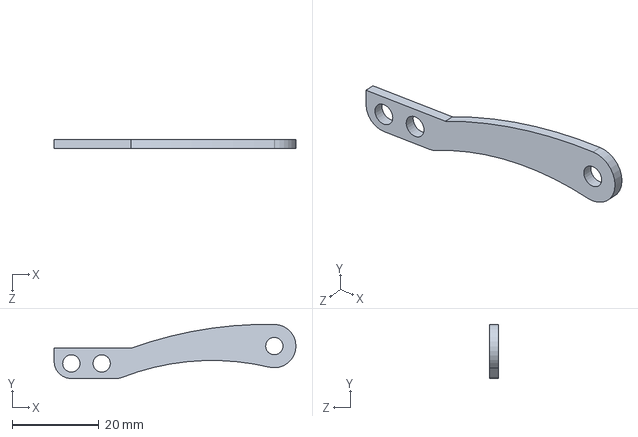
[picture p70: CAD file, 2021-11-14]
CAD Designs/Assembly/Part51.SLDPRT
55.8 x 12.5 x 2.00 mm
