Team-Sensorium/SensoBot/CAD Designs/Assembly/Grip part6.SLDPRT

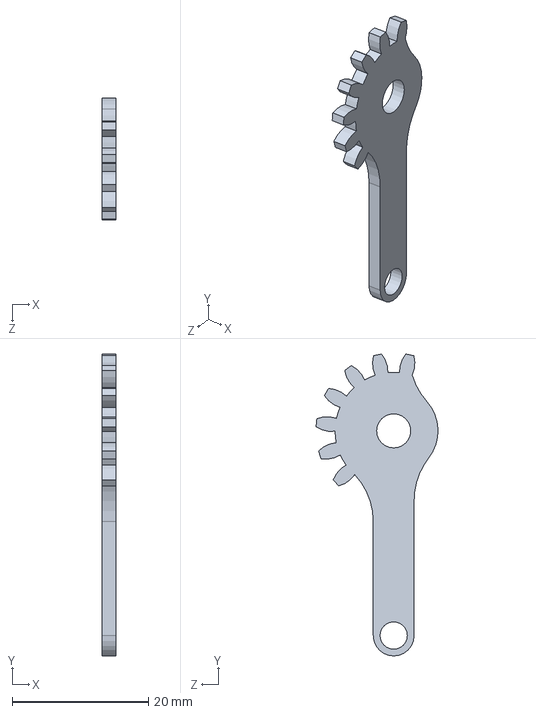
[picture p71: CAD file, 2021-11-14]
CAD Designs/Assembly/Grip part6.SLDPRT
2.00 x 44.3 x 17.9 mm
