Team-Sensorium/SensoBot/CAD Designs/Assembly/GRIP part2.SLDPRT

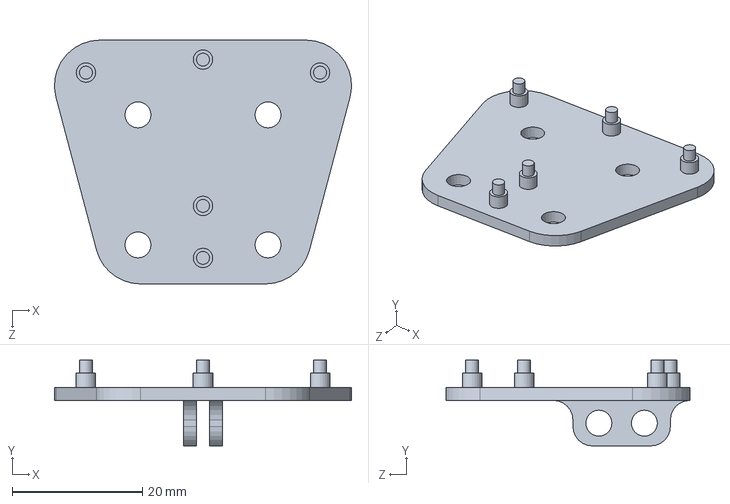
[picture p72: CAD file, 2021-11-14]
CAD Designs/Assembly/GRIP part2.SLDPRT
45.7 x 13.2 x 37.5 mm
