Team-Sensorium/SensoBot/(list of files, cad)

Other CAD files:
CAD Designs/Assembly for webots/chassy.STL
CAD Designs/Assembly for webots/Arena/Parts/floor_and_walls.SLDPRT
CAD Designs/Assembly/L293d motor controller module half H-bridge onshape.sldprt
CAD Designs/Assembly for webots/Arena/Parts/floor_and_walls.STL
CAD Designs/Assembly for webots/Assembly/chassy.SLDASM
CAD Designs/Assembly for webots/Assembly/chassy.SLDPRT
CAD Designs/Assembly for webots/Part2.STL
CAD Designs/Assembly for webots/path1.STL
