Team-Sensorium/SensoBot/(list of files, drawings)

Other design files:
Altium/Sensobot_wiring/Schlib_sensobot.SchLib
Altium/Sensobot_wiring/Sensobot_wiring.PrjPcb
Altium/Sensobot_wiring/Sheet1.SchDoc
