Team-Sensorium/SensoBot/(commit log)

2021-11-14 Addition: CAD files ARM files added
    [GRIP part1.SLDPRT, GRIP part2.SLDPRT, GRIP part3.SLDPRT, GRIP part4.SLDPRT, Grip part5.SLDPRT, Grip part6.SLDPRT, Grip part7.SLDPRT, Part51.SLDPRT]
2021-11-14 Addition: CAD files CHASSY files added
    [Part1 - Upper.SLDPRT, Part1.SLDPRT]
2021-11-14 Addition: CAD files SMALLPARTS files added
    [3mm spacer.SLDPRT]
2021-11-14 Addition: CAD files Assembly files added
    [3mm spacer.SLDPRT]
2021-11-14 Addition: Assembly parts added
2021-11-14 Addition: CAD assembly files added
    [Cam V2.1 v1.step, DC-DC Step Down Buck Converter CC-CV 300W 20A.step, GRIP part1.SLDPRT, GRIP part2.SLDPRT, GRIP part3.SLDPRT, GRIP part4.SLDPRT, Grip part6.SLDPRT, Grip part7.SLDPRT]
2022-02-23 All codes combined, Not rubst but working
    [CMYK_area_fillet.STL, entrance_path_test_arena.STL, floor_and_walls.SLDPRT, key_hole_outline.STL, maze_test_arena.STL, walls.STL]
2022-02-24 Maze solving task optimized
    [dotted_path1.STL]
2022-02-24 Schematic started
    [Schlib_sensobot.SchLib, Sensobot_wiring.PrjPcb, Sheet1.SchDoc]
2022-02-27 Project Ended
    [CMYK_area_fillet.STL, entrance_path_test_arena.STL, key_hole_outline.STL, maze_test_arena.STL]
